0xnullsect0r/DelphianBallisticsGroup/Rallus II v4/hardware/models/avionics_blade.png

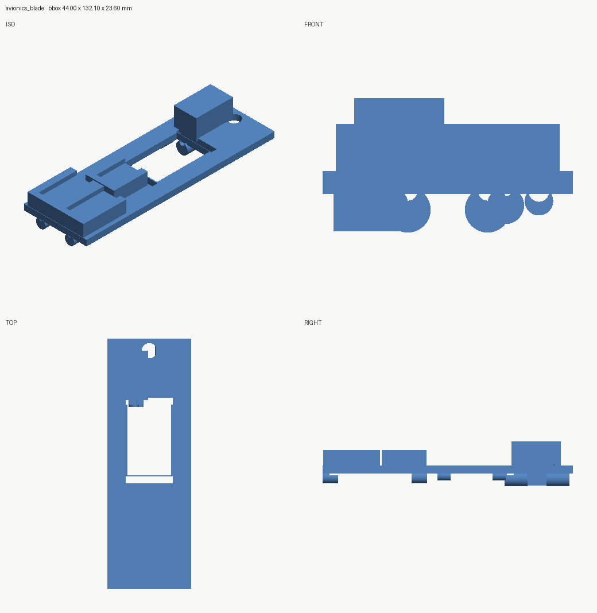
Rallus II v4/hardware/models/avionics_blade.png
