0xnullsect0r/DelphianBallisticsGroup/Rallus II v4/hardware/models/nose_base.png

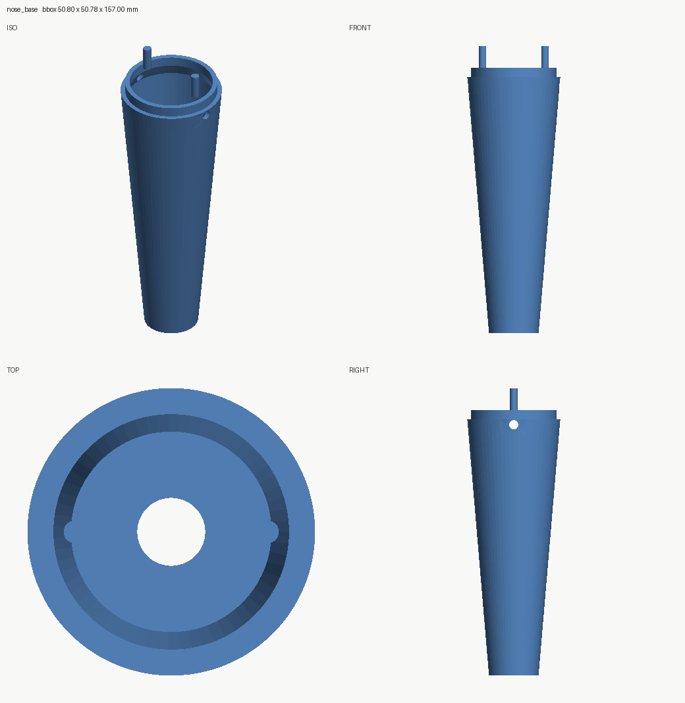
Rallus II v4/hardware/models/nose_base.png
