0xnullsect0r/DelphianBallisticsGroup/Rallus II v4/hardware/models/nose_base_plug_section_X0.png

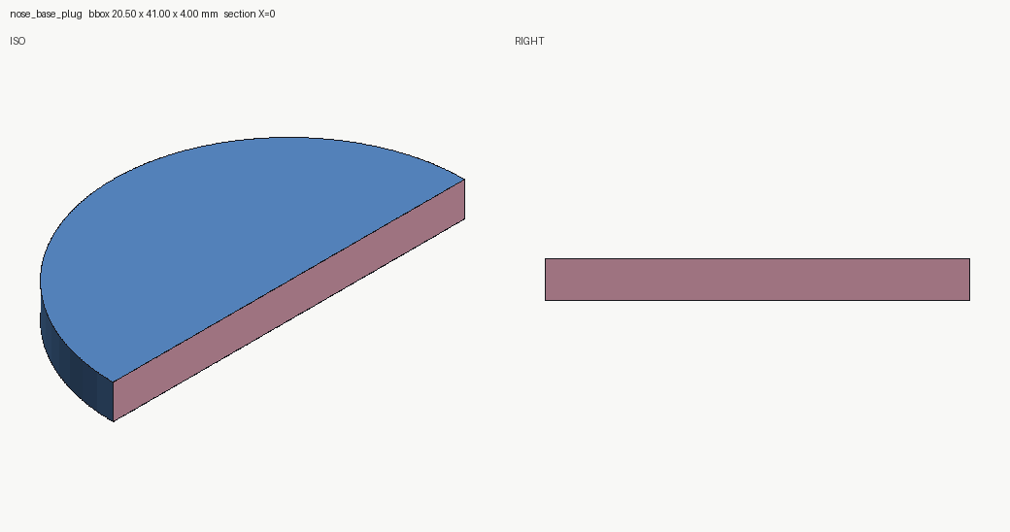
Rallus II v4/hardware/models/nose_base_plug_section_X0.png
