0xnullsect0r/DelphianBallisticsGroup/Rallus II v4/hardware/models/nose_tip.png

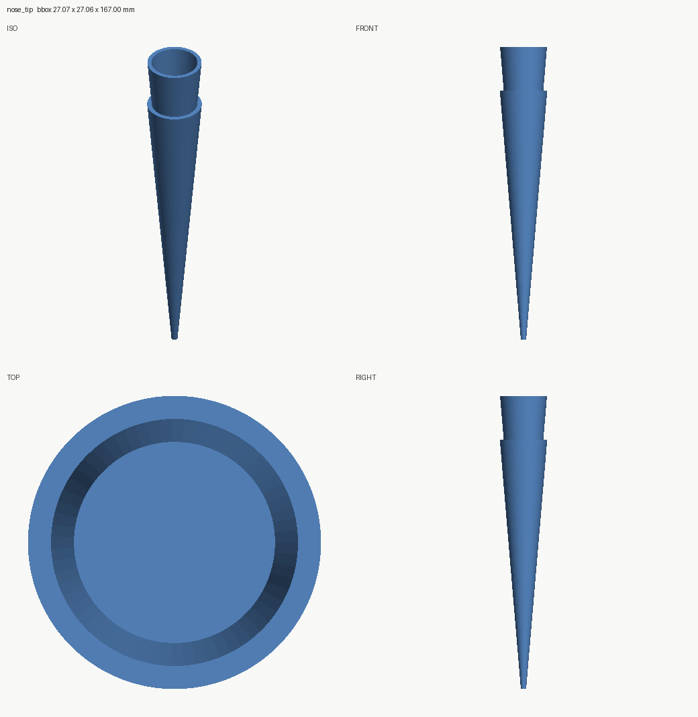
Rallus II v4/hardware/models/nose_tip.png
