0xnullsect0r/DelphianBallisticsGroup/Rallus II v4/hardware/models/nose_tip_section_X0.png

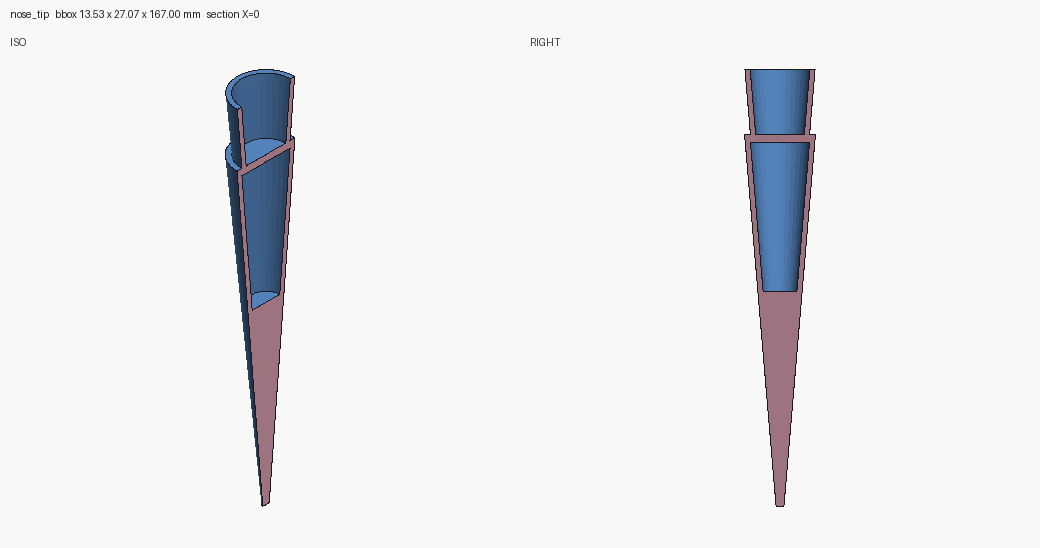
Rallus II v4/hardware/models/nose_tip_section_X0.png
