0xnullsect0r/DelphianBallisticsGroup/Rallus II v4/hardware/models/nosecone.png

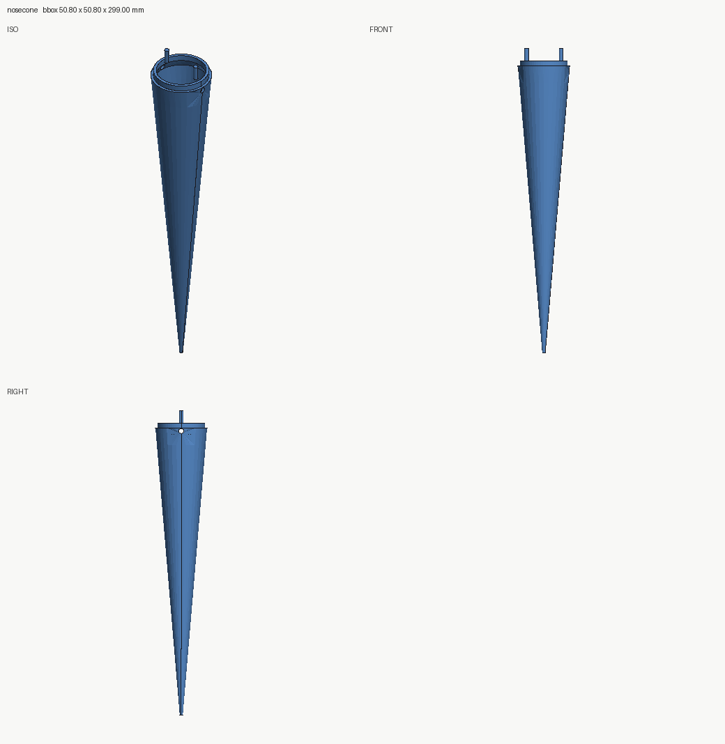
Rallus II v4/hardware/models/nosecone.png
