0xnullsect0r/DelphianBallisticsGroup/Rallus II v4/hardware/models/retention_ring.png

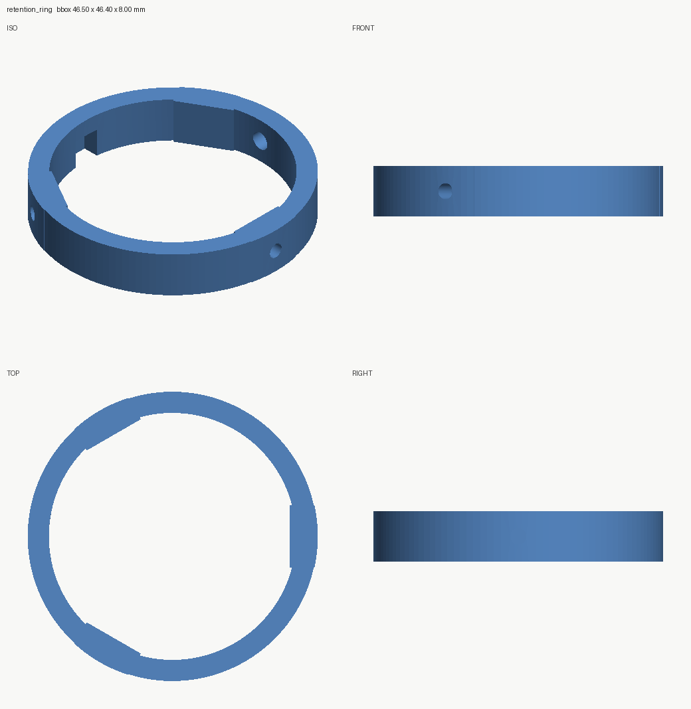
Rallus II v4/hardware/models/retention_ring.png
