0xnullsect0r/DelphianBallisticsGroup/Rallus II v4/hardware/models/retention_ring_section_Y0.png

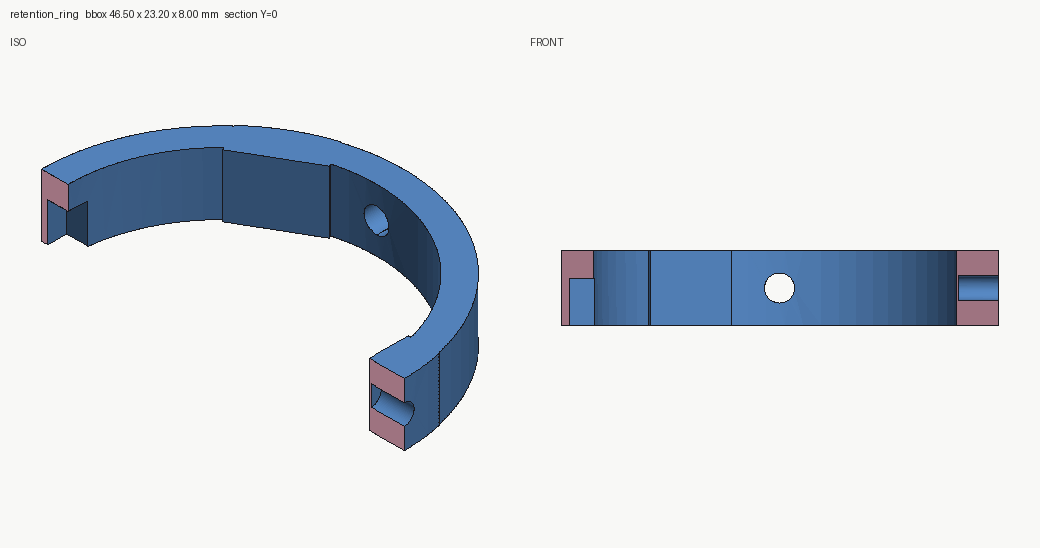
Rallus II v4/hardware/models/retention_ring_section_Y0.png
