0xnullsect0r/DelphianBallisticsGroup/Rallus II v4/BOM.md

# BOM, Rallus II v4 (printed nose, slide-in stack)

| Part | Qty | ~$ | Notes |
|---|---|---|---|
| Raspberry Pi Pico 2 | 1 | 5 | RP2350. Pico 2 W +$2 adds WiFi for future telemetry |
| GY-ICM42688-P breakout | 1 | 9 | 3.3V native. 32g range is mandatory on this motor (18.2g peak). Adafruit 4636 ($18) alternative |
| GY-MS5611 baro breakout | 1 | 8 | MS5611-01BA, SPI |
| W25Q128 SPI flash module | 1 | 5 | 16MB log storage |
| MAX31855 module + K-type probe (long lead) | 1 | 7 | Nosecone skin temp, SPI1, log field tc_c10; JST pair at the nose shoulder |
| Aluminium + kapton tape | - | 3 | Probe bonding on the nosecone (alu over bead, kapton over lead) |
| MG90S digital servo (metal gear) | 6 | 21 | 4 fly, 2 spares |
| 2S 450mAh LiPo (XT30 or JST) | 1 | 12 | Fits sled cradle (verify against dimensions.scad) |
| 5V/3A switching BEC | 1 | 7 | Feeds servo rail + Pico VSYS |
| Slide switch + RBF pin/jack | 1 set | 5 | Arm interlock, in series, mounts in sled bottom ring |
| 1000uF electrolytic, decoupling caps, headers, wire | - | 5 | |
| Resistor divider (10k/2k) for battery sense | 1 | 0.5 | 2S -> ADC |
| Brass sheet 1.5mm (canard stock) | 1 | 10 | 4x canards, 35/15.4/28 mm trapezoid per V3.ork |
| Steel sheet 1.5mm (if recutting booster fins) | 1 | 15 | Booster fins grew to 65 mm span; skip if fins already cut at 50 mm and we re-run numbers instead |
| 3mm CF or fiberglass rod (canard shafts) | 4 | 8 | Cut to length after fin can design |
| Lead shot + epoxy (nose ballast) | - | 10 | ~285 g into the nose cavity; assembled nose must weigh ~360 g |
| GoPro HERO5 Session | 1 | owned | Used market ~$40-60 if needed; 37mm cube, verify vs dimensions.scad |
| Clear packaging tape | 1 | have? | 2 fresh layers over the camera window per flight |
| Foam sheet, 1.5mm + velcro strap | - | 3 | Camera shock mount, battery strap |
| M2.5x8 screws (4) + M3x6 screws (4) | 1 set | 2 | Pico standoffs + retention ring clamp |
| PETG or CF-nylon filament | - | have? | Servo ring (CF-nylon preferred), cage, sled, templates |
| Commercial altimeter (existing?) | 1 | 0-60 | Fires chutes + explosive bolts. Not this board's job |
| Drill bits: 3.2, 6mm + needle files | - | have? | Vent, RFB, shafts, window filing |

**Control electronics subtotal: ~$100** (minus altimeter if owned, minus
filament if stocked).

Motor is our own custom propellant (EX) — nothing to buy; the CTI 1115J530
in the OpenRocket file is only the closest-equivalent thrust curve for sims.
When the grain is static-tested, replace the curve and re-run ORK + sim.

Deliberately NOT bought yet: radio modules, smaller servos. Revisit after
M3 flight data and if telemetry gets added.
