0xnullsect0r/DelphianBallisticsGroup/Rallus II v4/hardware/models/all_parts.png

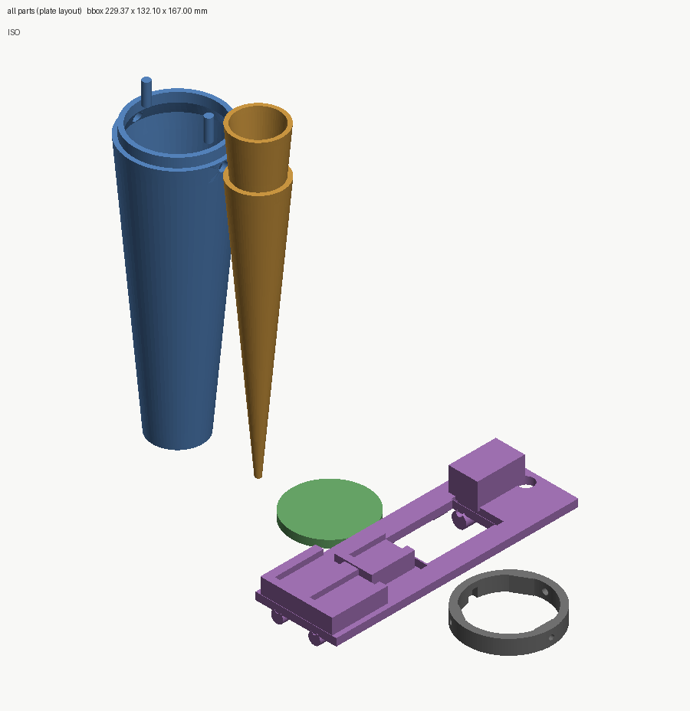
Rallus II v4/hardware/models/all_parts.png
