0xnullsect0r/DelphianBallisticsGroup/Rallus II v4/hardware/models/avionics_blade_bambu.3mf

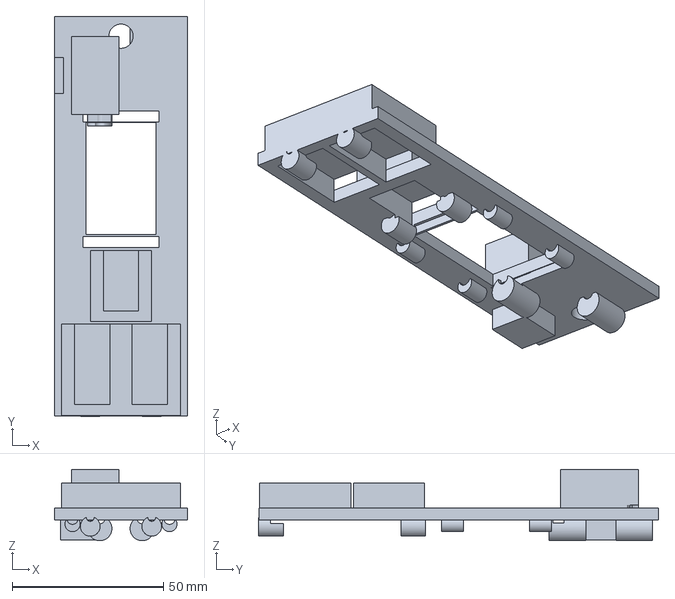
[picture p15: CAD file, 2026-11-11]
Rallus II v4/hardware/models/avionics_blade_bambu.3mf
44.0 x 132.1 x 23.6 mm
