0xnullsect0r/DelphianBallisticsGroup/Rallus II v4/hardware/models/rallus_plate_bambu.3mf

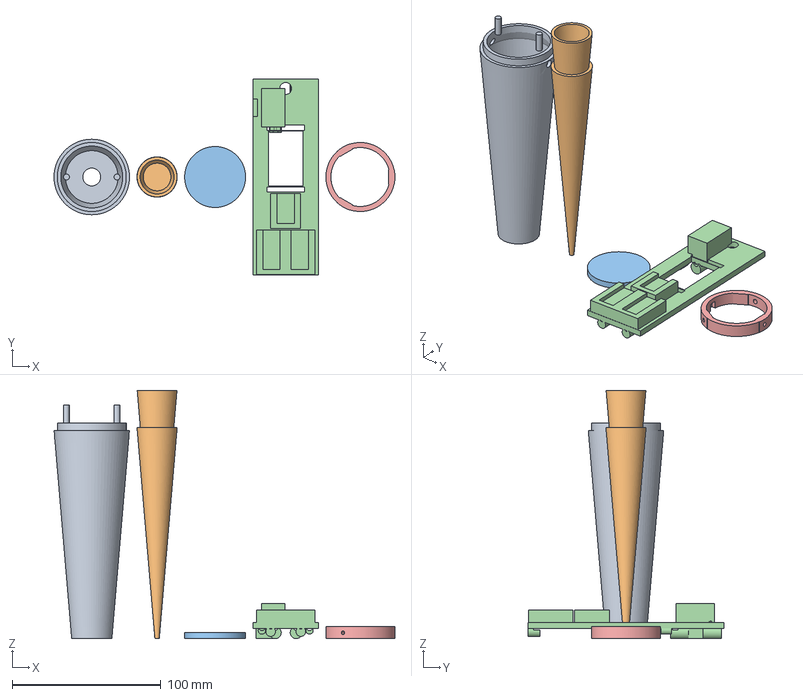
[picture p16: CAD file, 2026-11-11]
Rallus II v4/hardware/models/rallus_plate_bambu.3mf
229.4 x 132.1 x 167.0 mm
nose_base
nose_tip
nose_base_plug
avionics_blade
retention_ring
