0xnullsect0r/DelphianBallisticsGroup/Rallus II v4/hardware/models/nose_base_bambu.3mf

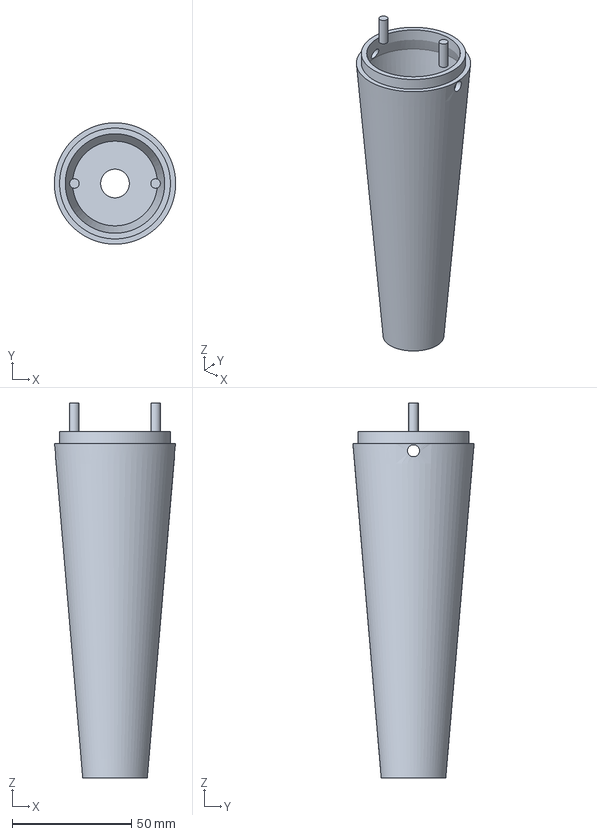
[picture p17: CAD file, 2026-11-11]
Rallus II v4/hardware/models/nose_base_bambu.3mf
50.8 x 50.8 x 157.0 mm
