0xnullsect0r/DelphianBallisticsGroup/Rallus II v4/hardware/models/retention_ring_bambu.3mf

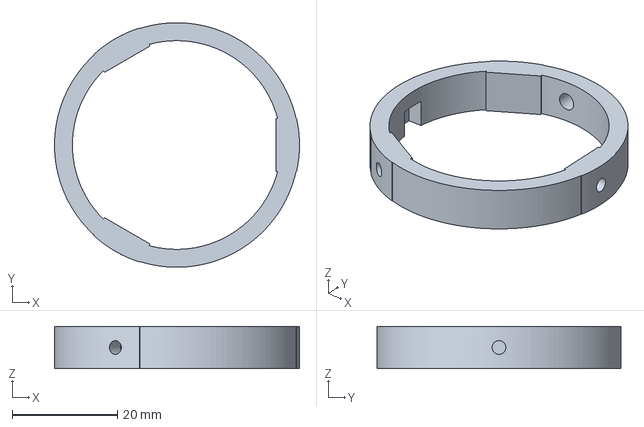
[picture p18: CAD file, 2026-11-11]
Rallus II v4/hardware/models/retention_ring_bambu.3mf
46.5 x 46.4 x 8.00 mm
