0xnullsect0r/DelphianBallisticsGroup/Rallus II v4/hardware/models/nose_tip_bambu.3mf

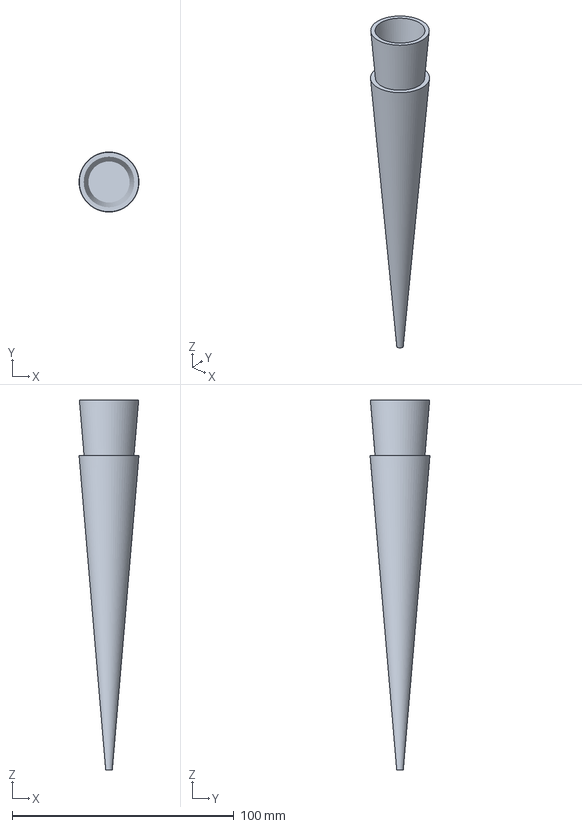
[picture p19: CAD file, 2026-11-11]
Rallus II v4/hardware/models/nose_tip_bambu.3mf
27.1 x 27.1 x 167.0 mm
