0xnullsect0r/DelphianBallisticsGroup/Rallus II v4/hardware/models/nosecone.step

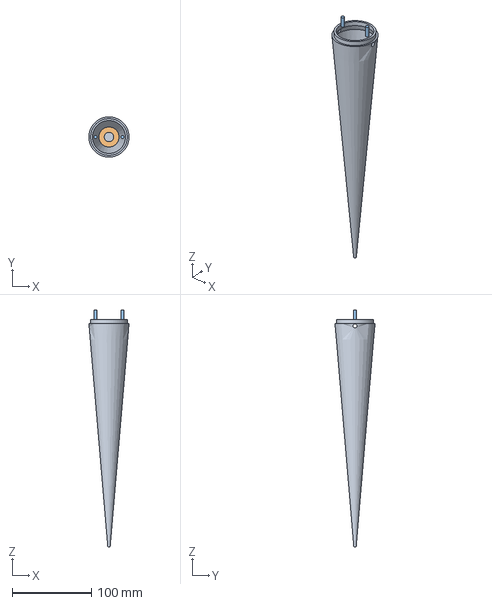
[picture p20: CAD file, 2026-11-11]
Rallus II v4/hardware/models/nosecone.step
50.8 x 50.8 x 299.0 mm
