0xnullsect0r/DelphianBallisticsGroup/(list of files, cad)

Other CAD files:
Rallus II v4/hardware/models/all_parts.3mf
Rallus II v4/hardware/models/nose_tip.step
Rallus II v4/hardware/models/retention_ring.step
Rallus II v4/hardware/models/nose_base.step
Rallus II v4/hardware/models/avionics_blade.step
Rallus II v4/hardware/models/nose_base_plug.step
Rallus II v4/hardware/models/avionics_blade.3mf
Rallus II v4/hardware/models/avionics_blade.stl
Rallus II v4/hardware/models/nose_base.3mf
Rallus II v4/hardware/models/nose_base.stl
Rallus II v4/hardware/models/nose_base_plug.3mf
Rallus II v4/hardware/models/nose_base_plug.stl
Rallus II v4/hardware/models/nose_tip.3mf
Rallus II v4/hardware/models/nose_tip.stl
Rallus II v4/hardware/models/retention_ring.3mf
Rallus II v4/hardware/models/retention_ring.stl
