0xnullsect0r/DelphianBallisticsGroup/Rallus II v4/hardware/models/assembly.png

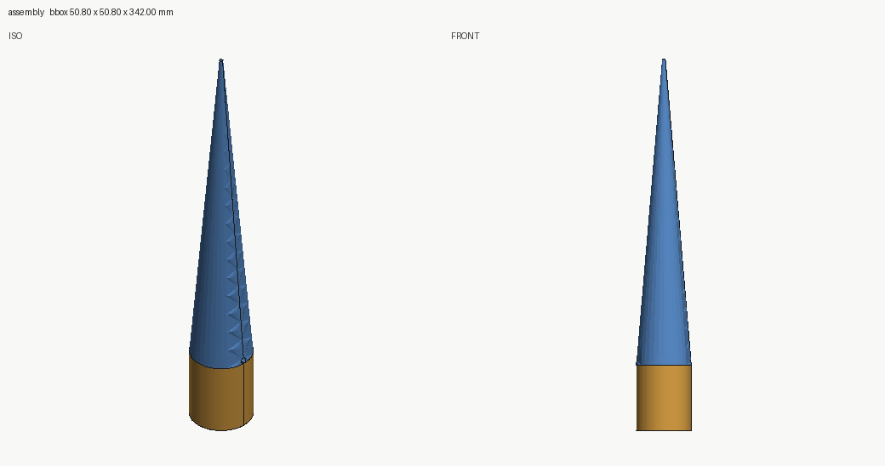
Rallus II v4/hardware/models/assembly.png
