0xnullsect0r/DelphianBallisticsGroup/(commit log)

2026-11-09 v2 Sim Results
    [something1.csv, something2.csv, something3.csv, something4.csv, something5.csv, something6.csv]
2026-11-10 fixed things
    [avionics_sled.scad, camera_cage.scad, canard_servo_ring.scad, dimensions.scad, drill_template.scad]
2026-11-10 Avionics Modeling
    [all_parts.3mf, avionics_blade.3mf, avionics_blade.step, avionics_blade.stl, avionics_blade_bambu.3mf, drill_template.scad, retention_ring.3mf, retention_ring.step]
2026-11-11 v4 (but again this time)
    [all_parts.3mf, nose_base.3mf, nose_base.step, nose_base.stl, nose_base_plug.3mf, nose_base_plug.step, nose_tip.3mf, nose_tip.step]
